Gene0Grey/cuffless-bp-monitor/docs/Cuffless_BP_Monitor_Report.docx

Cuffless Non-Invasive Blood Pressure
Monitoring System

Using ECG (AD8232) and Multi-Site PPG (MAX30102) with Pulse Transit Time

Design, Build & Signal-Processing Report

Platform: ESP32 • Wireless (WiFi) Telemetry

Date: October 2026

# Table of Contents

Right-click here and choose 'Update Field' to build the contents.

# 1. Executive Summary

This report documents the design and construction of a cuffless, non-invasive blood pressure (BP) monitoring system. Unlike conventional cuff-based monitors, the system estimates blood pressure continuously by measuring the Pulse Transit Time (PTT) — the delay between the heart's electrical activity (ECG) and the arrival of the resulting pulse wave at peripheral sites (PPG).

The system uses a single AD8232 ECG module as the timing reference and four MAX30102 photoplethysmography (PPG) sensors placed at multiple body sites (both fingertips and the earlobes). Because all MAX30102 sensors share the same fixed I²C address, a TCA9548A I²C multiplexer addresses them individually. An ESP32 microcontroller performs acquisition, digital filtering, and wireless (WiFi) transmission of the data.

The report covers the measurement principle, system architecture, complete wiring, power-supply design (USB and battery/boost options), the digital signal-processing pipeline developed to obtain clean signals, testing and troubleshooting notes, current limitations, and the roadmap toward the final BP calculation.

# 2. Project Objective

- Build a cuffless, non-invasive system capable of estimating blood pressure continuously.
- Acquire a synchronized ECG signal and multiple PPG signals from different body sites.
- Compute Pulse Transit Time (PTT) between the ECG R-peak and each PPG pulse.
- Map PTT to blood pressure using a per-user calibration against a reference cuff.
- Make the device portable and wireless — battery powered with WiFi telemetry.

# 3. Measurement Principle

Blood pressure is not measured directly. Instead, the system relies on the well-established relationship between arterial pressure and the speed at which the pulse wave travels through the arteries.

## 3.1 Pulse Transit Time (PTT)

Each heartbeat produces a sharp electrical spike — the R-peak — visible on the ECG. This marks the instant the heart contracts (time t = 0). The pressure pulse then travels along the arteries and arrives at a peripheral site (fingertip, earlobe) a short time later, where the PPG sensor detects it as a rise in blood volume.

PTT is the delay between the ECG R-peak and the foot (or peak) of the PPG pulse. A higher blood pressure stiffens the arteries and makes the pulse travel faster, shortening PTT. The relationship is commonly modelled as:

BP ≈ a · (1 / PTT²) + b

where the coefficients a and b are determined for each individual through calibration against a standard cuff reading.

## 3.2 Why multiple PPG sites

Using PPG sensors at both a proximal site (earlobe, short PTT) and distal sites (fingertips, longer PTT) provides multiple transit-time measurements. This improves robustness, allows cross-checking, and helps reject motion artefacts. In this build the ECG provides the shared timing reference, and each PPG stream is aligned to it independently.

# 4. System Architecture

The signal flow of the complete system is summarised below.

- ECG path: AD8232 → analog output → ESP32 ADC (GPIO34). Continuous, high-rate sampling for R-peak detection.
- PPG path: 4 × MAX30102 → TCA9548A I²C multiplexer → ESP32 I²C bus (GPIO21/22). Sensors read one at a time.
- Processing: ESP32 filters both signals digitally and (in the final system) computes PTT and BP.
- Telemetry: ESP32 hosts a WiFi web dashboard for live waveform viewing; USB serial is used during development.
- Power: USB during development; LiPo battery + XL6009 boost converter for portable operation.

The AD8232 is an analog device and therefore bypasses the multiplexer entirely — only the four identical-address PPG sensors require multiplexing.

# 5. Bill of Materials

Component | Part | Qty | Purpose
Microcontroller | ESP32 DevKit (CP2102) | 1 | Acquisition, DSP, WiFi telemetry
I²C multiplexer | TCA9548A | 1 | Address 4 identical PPG sensors
PPG sensor | MAX30102 | 4 | Pulse detection (2 fingers, 2 earlobes)
ECG module | AD8232 + electrodes | 1 | Heart signal / R-peak reference
Battery | LiPo 3.7 V, 1250 mAh | 1 | Portable power source
Boost converter | XL6009 | 1 | Step battery up to a stable 5 V
Capacitors | 2× 470 µF, 2× 0.1 µF | 4 | Decoupling / stabilise boost output
Misc. | Breadboard, jumpers, USB cable | — | Prototyping

# 6. Circuit Connections (USB-Powered Build)

During development the entire circuit is powered from the ESP32's USB port. The regulated 3.3 V pin feeds a common positive rail; all grounds share a common negative rail — this shared ground is essential for I²C and for a clean ECG reading.

## 6.1 Power Rails

From | To
ESP32 3V3 | Breadboard + rail
ESP32 GND | Breadboard − rail

## 6.2 ESP32 → TCA9548A Multiplexer

TCA9548A pin | Connects to
VIN | + rail
GND | − rail
SDA | ESP32 GPIO21
SCL | ESP32 GPIO22
A0, A1, A2 | − rail (I²C address 0x70)
RST | + rail

## 6.3 TCA9548A → 4 × MAX30102 (PPG)

MAX30102 | VIN | GND | SDA → | SCL →
#1 (finger) | + rail | − rail | SD0 | SC0

#2 (finger) | + rail | − rail | SD1 | SC1

#3 (earlobe) | + rail | − rail | SD2 | SC2

#4 (earlobe) | + rail | − rail | SD3 | SC3

The INT / RD / IRD pins on each MAX30102 are left unconnected.

## 6.4 ESP32 → AD8232 (ECG)

AD8232 pin | Connects to
3.3V | + rail
GND | − rail
OUTPUT | ESP32 GPIO34 (ADC1)
LO+ | ESP32 GPIO32
LO− | ESP32 GPIO33
SDN | Leave unconnected

Electrode placement: RA = right collarbone, LA = left collarbone, RL = left lower rib (reference).

# 7. Power Supply Design (Portable Build)

For portable operation the USB cable is replaced by a 3.7 V LiPo battery. Because the battery voltage (3.0–4.2 V) is too low and too variable for the ESP32's onboard regulator, an XL6009 boost converter raises it to a stable 5 V fed into the ESP32 VIN pin.

## 7.1 Main Power Path

From | To
LiPo + | XL6009 IN+
LiPo − | XL6009 IN−
XL6009 OUT+ (set to 5.0 V) | ESP32 VIN
XL6009 OUT− | ESP32 GND

## 7.2 Decoupling Capacitors

The XL6009 ran hot due to input ripple at low battery voltage. Decoupling capacitor pairs (one bulk electrolytic + one ceramic) were added at both the input and output terminals to smooth current surges and reduce heating.

Capacitor | Placed across | Function
470 µF electrolytic | IN+ / IN− | Absorbs input current surges (reduces heat)
0.1 µF ceramic | IN+ / IN− | Removes high-frequency switching noise
470 µF electrolytic | OUT+ / OUT− | Smooths 5 V output (WiFi current spikes)
0.1 µF ceramic | OUT+ / OUT− | Removes high-frequency noise

Key safety notes:

- Set the boost output to exactly 5.0 V with a multimeter before connecting it to the ESP32.
- Observe electrolytic polarity — long leg is +, stripe side is −.
- Never power the ESP32 from USB and the boost converter simultaneously.
- Mount capacitors with short leads, close to the converter terminals.
- Flash firmware over USB first; only then switch to battery power.

# 8. Firmware & Signal Processing

The ESP32 firmware acquires the ECG on a timed loop and reads each PPG sensor through the multiplexer. Raw signals were initially very noisy and prone to saturation, so a multi-stage digital signal-processing (DSP) pipeline was developed.

## 8.1 Acquisition

- Processing loop runs at 200 Hz; data is printed/transmitted at 50 Hz for readable waveforms.
- MAX30102 configured with hardware sample-averaging (×4) and FIFO read to prevent stale-data 'stepping'.
- ECG read from GPIO34 with 16× ADC oversampling to reduce converter noise.
- Multiplexer channel selected before each PPG transaction (ch0=0x01 … ch3=0x08).

## 8.2 Filtering Pipeline

Stage | Technique | Removes / Purpose
Hardware averaging | MAX30102 avg ×4 | Random PPG sensor noise
Oversampling | 16× ADC average (ECG) | ADC jitter
High-pass | Slow EMA baseline subtract | Baseline wander / DC drift
Mains notch | 2nd-order IIR biquad (50/60 Hz) | Power-line hum
Low-pass | 2-pole cascaded EMA | High-frequency fuzz
Median filter | Median-of-3 (PPG) | Motion spikes
Finger gate | DC-level threshold | Prevents empty-channel railing
Gain | Adjustable software gain | Amplifies clean signal

## 8.3 Key Problems Solved

- Saturation at ±8000: empty/no-finger PPG channels were amplified into the clamp. Fixed with a DC-level 'finger-present' gate that outputs a flat zero when no finger is detected.
- Insane values: unconnected channels and failed reads produced huge spikes. Fixed with sensor auto-detection (part-ID 0x15) and failed-read handling.
- Mains hum: replaced a crude moving average with a proper IIR notch tuned to the local mains frequency.
- Scaling conflict: ECG (0–4095) dwarfed PPG on shared plots; the WiFi dashboard shows ECG and PPG in separate, independently auto-scaled panels.

## 8.4 Wireless Telemetry

The ESP32 connects to WiFi (station mode) with a static IP and hosts a lightweight web dashboard. A browser on the same network displays live ECG and PPG waveforms in two separate panels, requiring no additional PC software. USB serial remains available for development and for reading the device IP.

# 9. Testing & Troubleshooting Log

Symptom | Root cause | Resolution
Garbled serial output | Board/crystal or baud mismatch | Correct board selection; 115200 baud
Values 'insane' / spiking | Unconnected channels, failed reads | Sensor auto-detect + read guards
Signal stuck at ±8000 | Gain pushing empty channel to clamp | Finger-presence DC gate
Boost converter overheating | Input ripple at low battery V | Input + output decoupling capacitors
COM port not detected | Descriptor failure (VID_0000) | Data cable + isolate external power

USB connectivity note:

A diagnostic scan confirmed the CP210x driver is installed and the board is registered as COM5. A 'Device Descriptor Request Failed' (VID_0000 & PID_0002) indicated an electrical/physical fault rather than a driver issue — resolved by using a known-good data cable and disconnecting external power (boost/sensors) so the board could enumerate without brownout.

# 10. Limitations

- Calibration required: cuffless PTT-based BP needs per-user calibration against a cuff and drifts over time; best treated as a trend/relative monitor.
- Multiplexed PPG: sensors are read one at a time, so timing must be reconstructed in software rather than sampled simultaneously.
- ESP32 ADC: the internal ADC is noisy; oversampling mitigates but does not eliminate this. An external ADC would improve ECG fidelity.
- Motion sensitivity: PPG and ECG are both susceptible to movement and poor electrode/sensor contact.
- Not a medical device: for research and educational use only; not validated for clinical diagnosis.

# 11. Next Steps & Future Work

1. Implement R-peak detection on the ECG stream (e.g. Pan–Tompkins-style thresholding).
2. Implement PPG pulse-foot detection for each channel.
3. Compute PTT = t(PPG foot) − t(ECG R-peak) per site and per beat.
4. Perform calibration against a reference cuff to derive coefficients a and b.
5. Run on-device BP calculation and transmit only the final BP value.
6. Optionally add OTA updates for fully wireless reflashing, and package into a wearable form factor.

# 12. Conclusion

A complete hardware platform for cuffless blood-pressure estimation has been designed and built around an ESP32, four MAX30102 PPG sensors on a TCA9548A multiplexer, and an AD8232 ECG module. A robust multi-stage DSP pipeline now yields clean, centred ECG and PPG signals, and a WiFi dashboard provides live visualisation. The power-supply and connectivity issues encountered during the build have been diagnosed and resolved. The remaining work is algorithmic: detecting fiducial points, computing PTT, and calibrating the PTT-to-BP mapping to turn the clean signals into blood-pressure readings.

Cuffless BP Monitor — Project Report | Page
