Gene0Grey/cuffless-bp-monitor/hardware/docs/bom.csv

Reference | Value | Footprint | QUANTITY
C1 | 10uF | Capacitor_THT:CP_Radial_D5.0mm_P2.50mm | 1
H1-H4 | MountingHole | MountingHole:MountingHole_3.2mm_M3 | 4
J1 | 5V_IN | ppg:JST_PH_B2B-PH-K_1x02_P2.00mm_Vertical_HandDrill | 1
JP1-JP4 | GND_LINK | ppg:WireLink_P5.08mm | 4
JP5 | RST_3V3 | ppg:WireLink_P5.08mm | 1
U1 | ESP32-DevKitV1 | ppg:ESP32_DevKitV1_30pin | 1
U2 | TCA9548A | ppg:TCA9548A_Module_HW-617 | 1
U3 | PPG1_CH0 | ppg:MAX30102_MH-ET_LIVE | 1
U4 | PPG2_CH1 | ppg:MAX30102_MH-ET_LIVE | 1
U5 | PPG3_CH2 | ppg:MAX30102_MH-ET_LIVE | 1
U6 | PPG4_CH3 | ppg:MAX30102_MH-ET_LIVE | 1
U7 | AD8232 | ppg:AD8232_SparkFun_SEN-12650 | 1
