Gene0Grey/cuffless-bp-monitor/hardware/docs/schematic.pdf

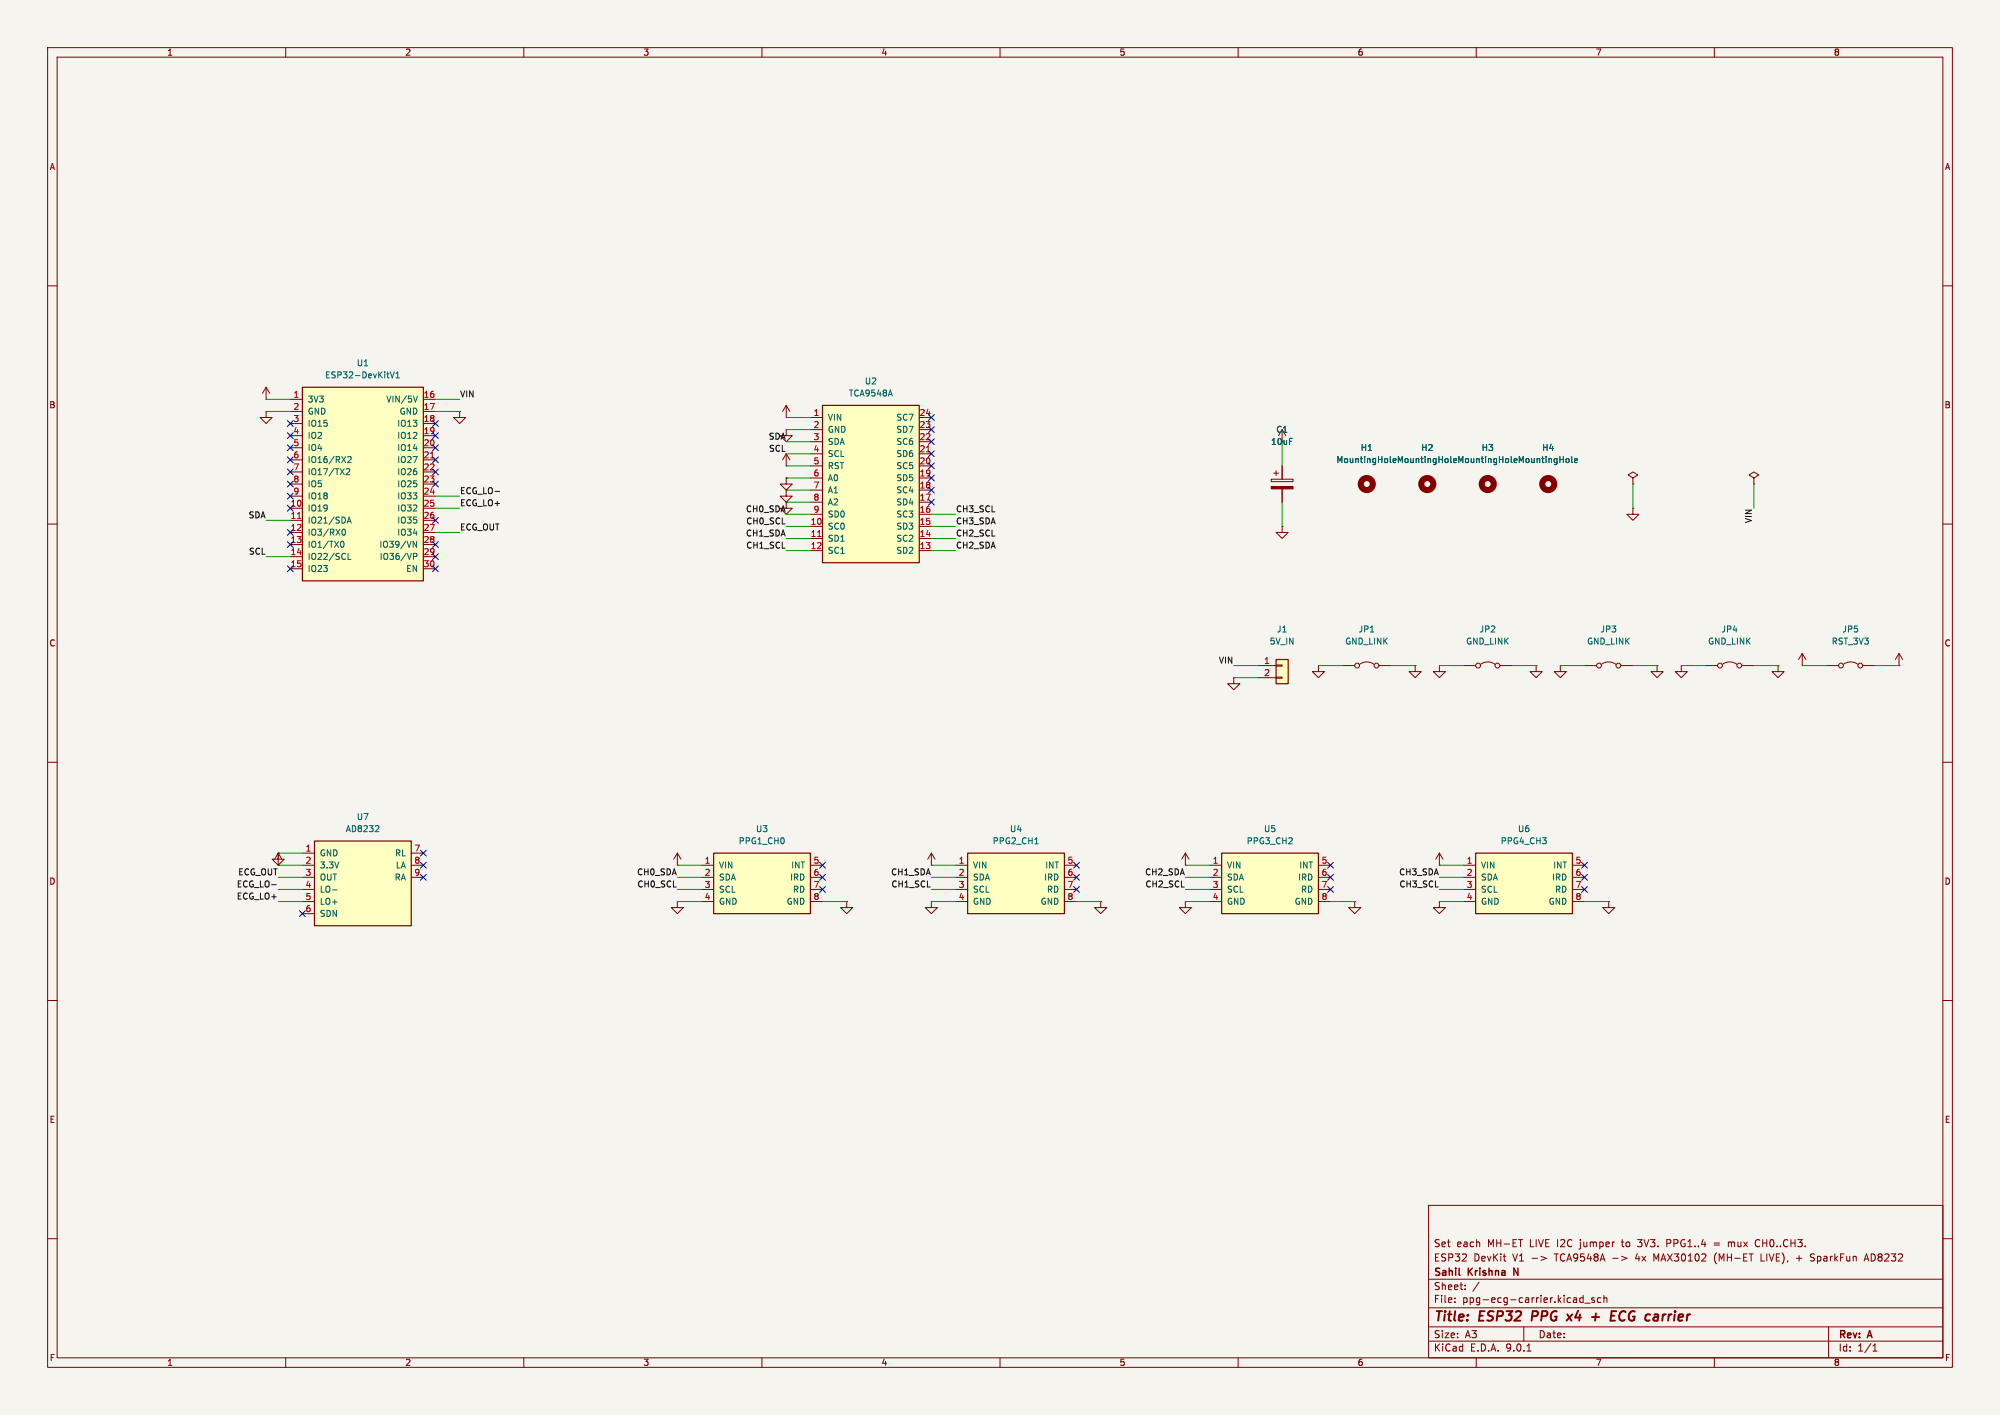
[picture p13: page 1]

VIN 1 SDA 2 SCL 3 GND 4

ESP32 | DevKit V1 -> | MH-ET | LIVE | TCA9548A -> I2C jumper to 3V3. | 4x MAX30102 | PPG1..4 = mux | (MH-ET | CH0..CH3. LIVE), + | SparkFun AD8232 Set each

ppg-ecg-carrier.kicad_sch Sheet: / Sahil Krishna N Id: 1/1 Title: ESP32 PPG x4 + ECG carrier File:
