Gene0Grey/cuffless-bp-monitor/hardware/docs/assembly-top.pdf

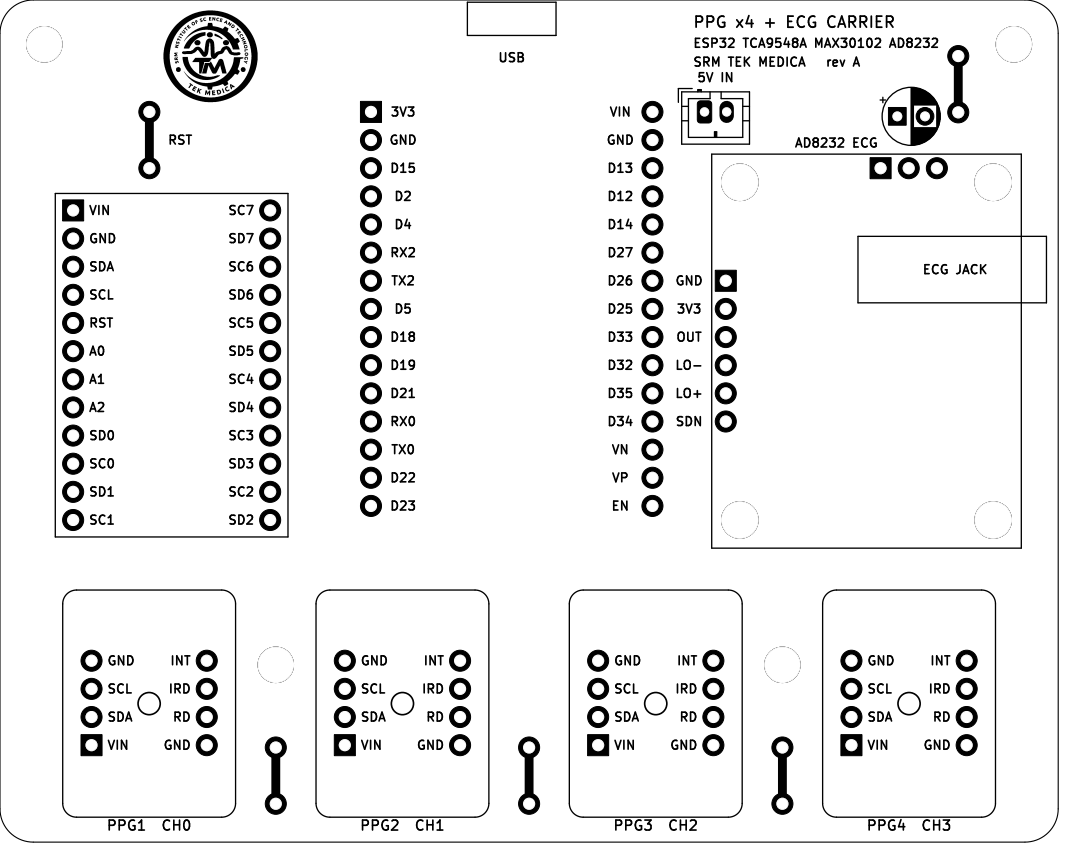
[picture p14: page 1]
