Gene0Grey/cuffless-bp-monitor/hardware/docs/drill-map.pdf

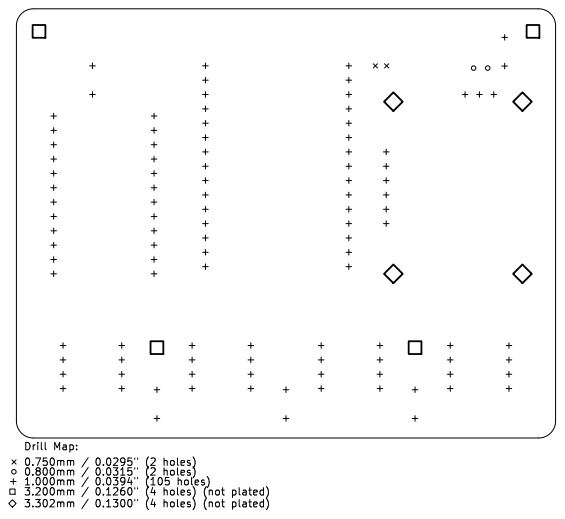
[picture p15: page 1]
