Gene0Grey/cuffless-bp-monitor/hardware/docs/etch-bottom.pdf

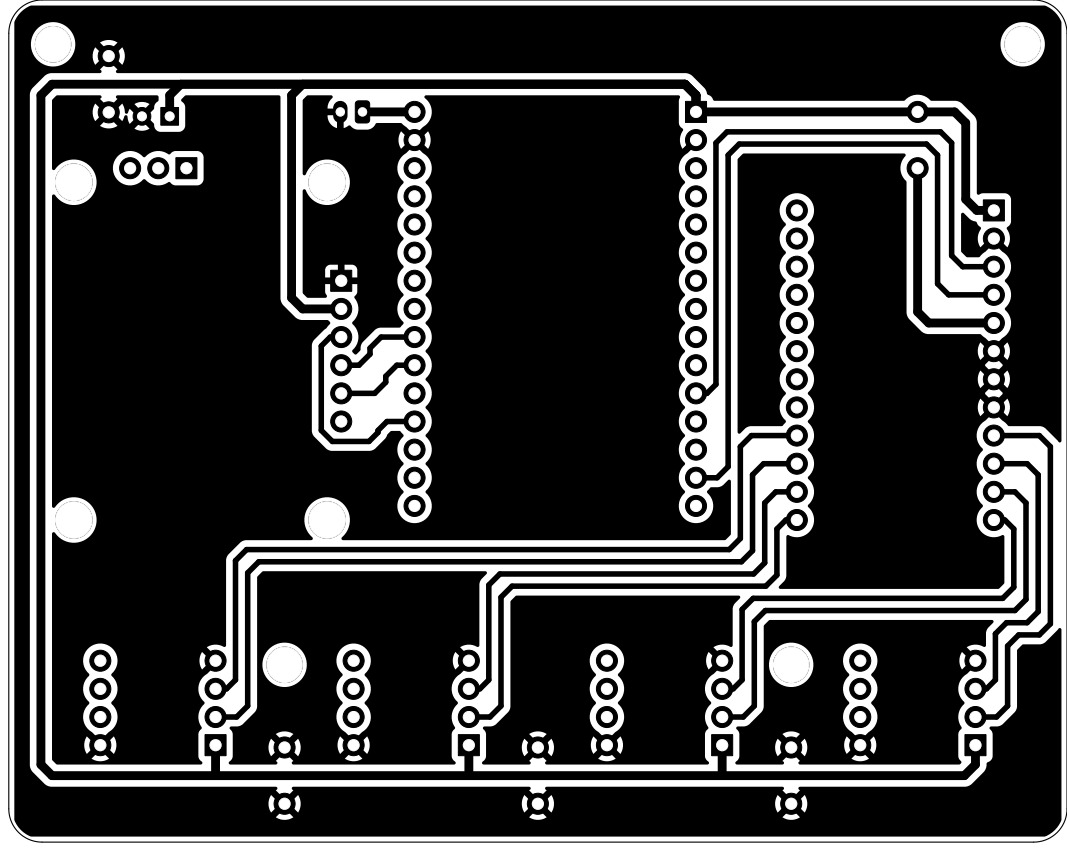
[picture p16: page 1]
