Gene0Grey/cuffless-bp-monitor/hardware/ppg-ecg-carrier.kicad_pcb

## KiCad design hardware/ppg-ecg-carrier.kicad_pcb (2026-10-01)

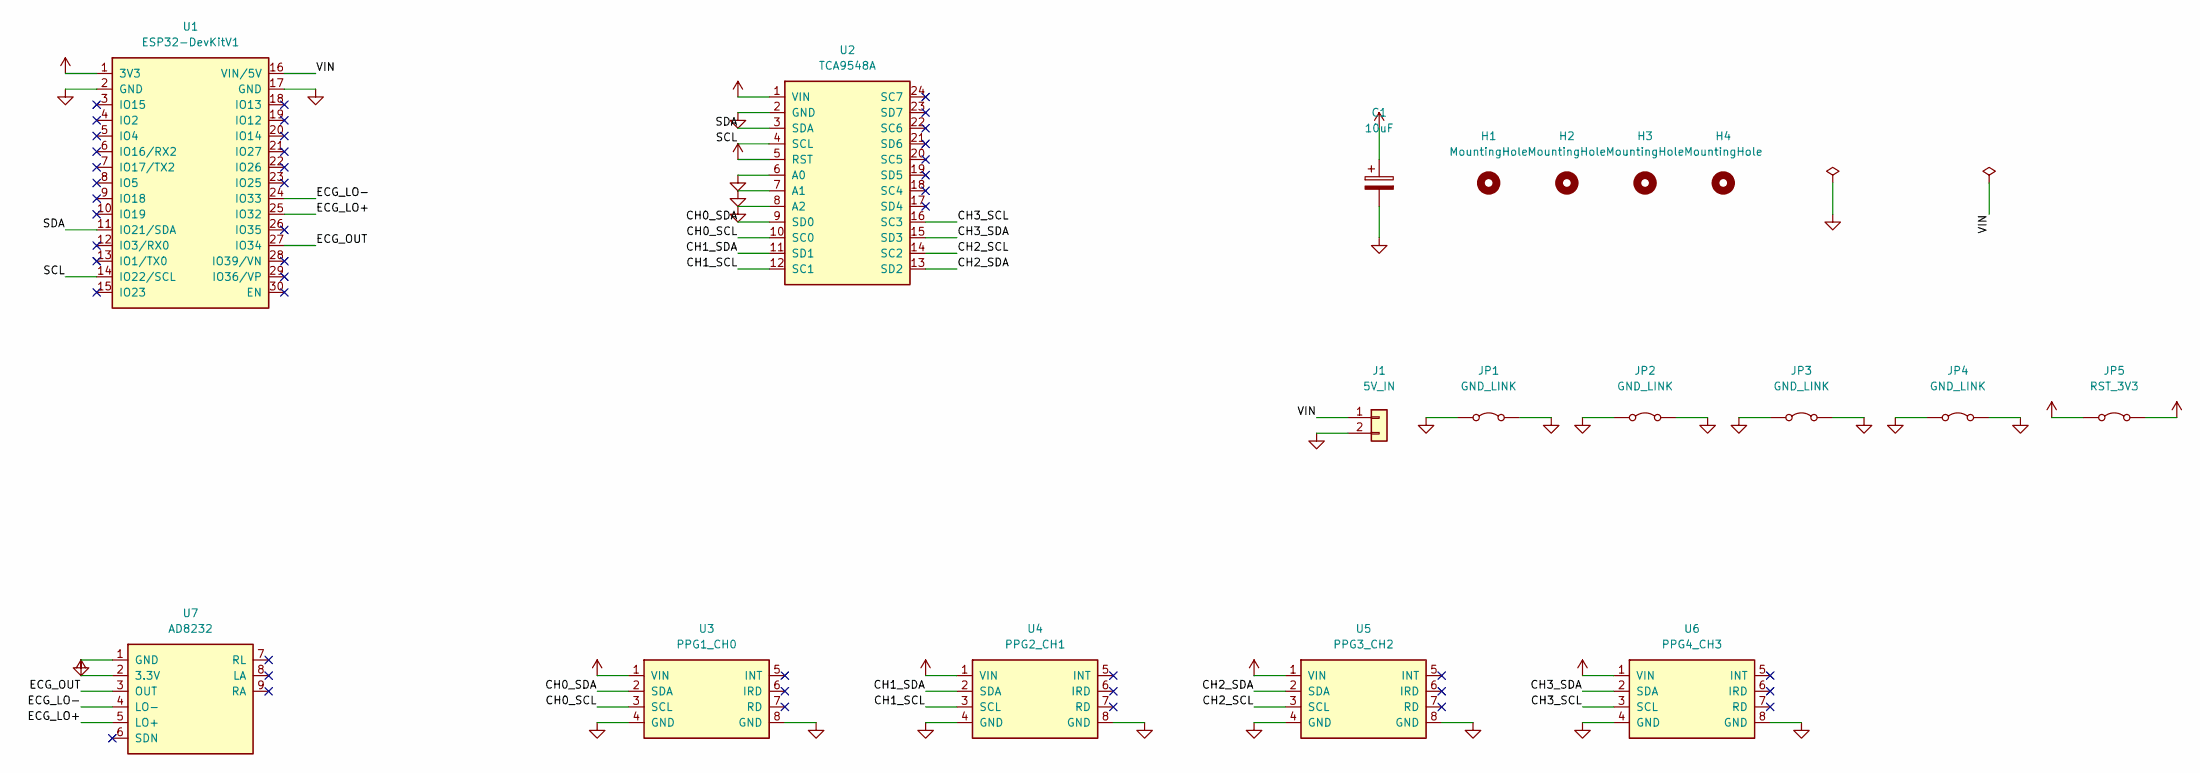
[picture p17: schematic ppg-ecg-carrier.kicad_sch, ESP32 PPG x4 + ECG carrier]

Parts:
C1: 10uF; CP_Radial_D5.0mm_P2.50mm
H1, H2, H3, H4: MountingHole; MountingHole_3.2mm_M3
J1: 5V_IN; JST_PH_B2B-PH-K_1x02_P2.00mm_Vertical_HandDrill
JP1, JP2, JP3, JP4: GND_LINK; WireLink_P5.08mm
JP5: RST_3V3; WireLink_P5.08mm
U1: ESP32-DevKitV1; ESP32_DevKitV1_30pin
U2: TCA9548A; TCA9548A_Module_HW-617
U3: PPG1_CH0; MAX30102_MH-ET_LIVE
U4: PPG2_CH1; MAX30102_MH-ET_LIVE
U5: PPG3_CH2; MAX30102_MH-ET_LIVE
U6: PPG4_CH3; MAX30102_MH-ET_LIVE
U7: AD8232; AD8232_SparkFun_SEN-12650

Connections:
+3V3: C1.1, JP5.1 (A), JP5.2 (B), U1.1 (3V3), U2.1 (VIN), U2.5 (RST), U3.1 (VIN), U4.1 (VIN), U5.1 (VIN), U6.1 (VIN), U7.2 (3.3V)
/CH0_SCL: U2.10 (SC0), U3.3 (SCL)
/CH0_SDA: U2.9 (SD0), U3.2 (SDA)
/CH1_SCL: U2.12 (SC1), U4.3 (SCL)
/CH1_SDA: U2.11 (SD1), U4.2 (SDA)
/CH2_SCL: U2.14 (SC2), U5.3 (SCL)
/CH2_SDA: U2.13 (SD2), U5.2 (SDA)
/CH3_SCL: U2.16 (SC3), U6.3 (SCL)
/CH3_SDA: U2.15 (SD3), U6.2 (SDA)
/ECG_LO+: U1.25 (IO32), U7.5 (LO+)
/ECG_LO-: U1.24 (IO33), U7.4 (LO-)
/ECG_OUT: U1.27 (IO34), U7.3 (OUT)
/SCL: U1.14 (IO22/SCL), U2.4 (SCL)
/SDA: U1.11 (IO21/SDA), U2.3 (SDA)
/VIN: J1.1, U1.16 (VIN/5V)
GND: C1.2, J1.2, JP1.1 (A), JP1.2 (B), JP2.1 (A), JP2.2 (B), JP3.1 (A), JP3.2 (B), JP4.1 (A), JP4.2 (B), U1.2 (GND), U1.17 (GND), U2.2 (GND), U2.6 (A0), U2.7 (A1), U2.8 (A2), U3.4 (GND), U3.8 (GND), U4.4 (GND), U4.8 (GND), U5.4 (GND), U5.8 (GND), U6.4 (GND), U6.8 (GND), U7.1 (GND)

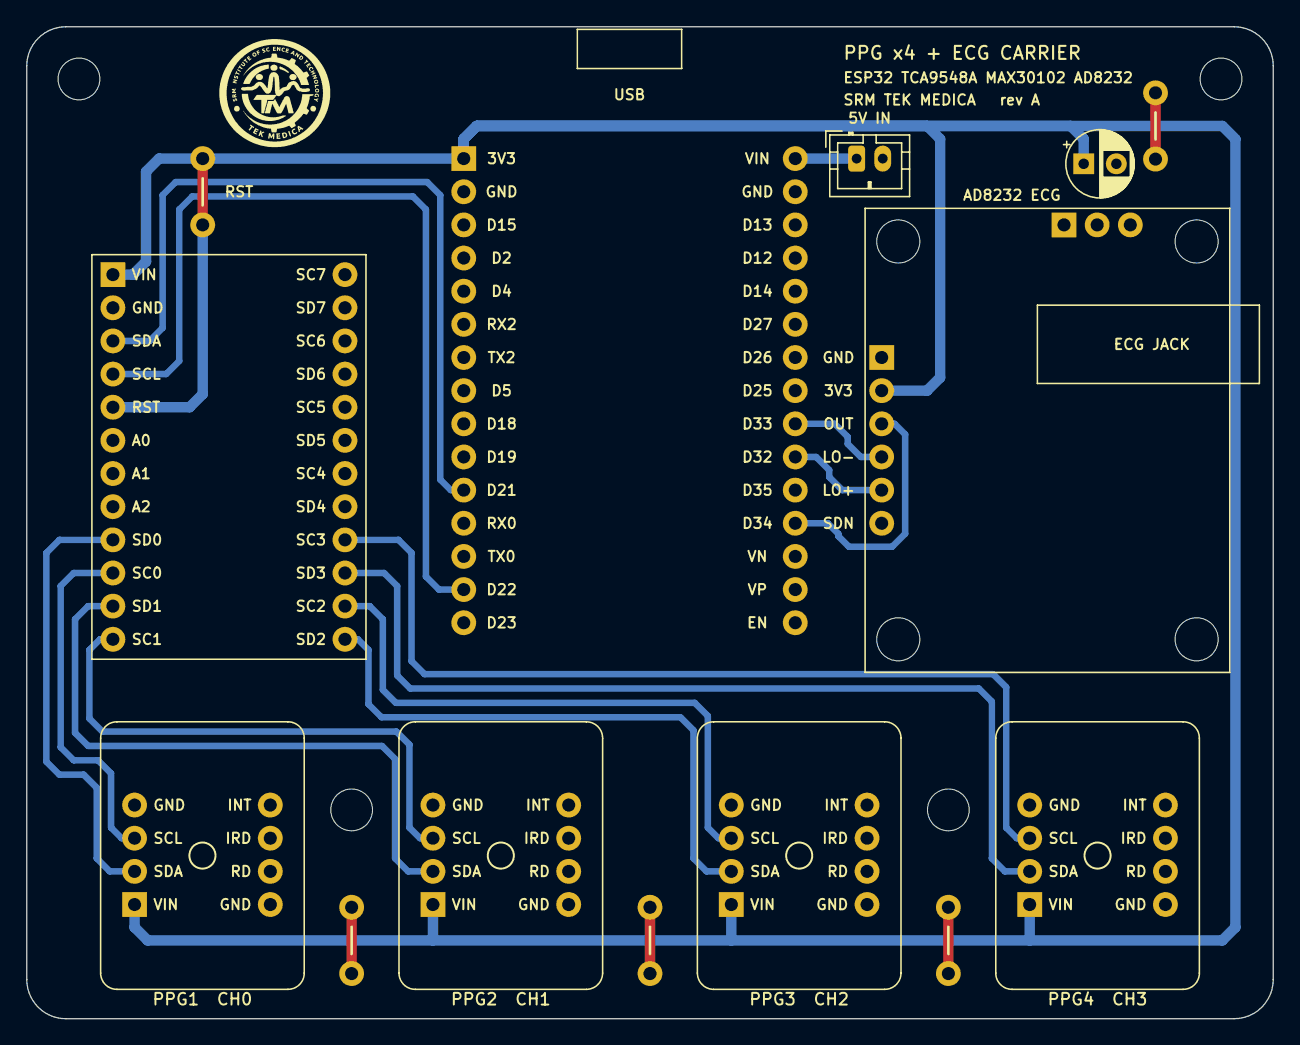
[picture p18: board ppg-ecg-carrier.kicad_pcb from above]

Board: 2 copper layers, 95.5 x 76.0 mm, 18 parts (0 on the bottom side), 16 nets.
