Gene0Grey/cuffless-bp-monitor/(commit log)

2026-10-01 Cuffless BP monitor: carrier PCB, firmware and report
    ESP32 + TCA9548A + 4x MAX30102 (PPG) + AD8232 (ECG) carrier board for
    cuffless blood-pressure estimation by pulse transit time.
    - hardware/: KiCad 9 project, single-sided home-etchable board, Gerbers,
    drill file, renders, schematic and etch/assembly PDFs, BOM
    - firmware/: ESP32 sketch (200 Hz ECG + 4-channel PPG DSP, USB serial)
    - docs/: project report
    [bom.csv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]
2026-10-01 Add renders, schematic image, system and PTT diagrams to README
2026-10-01 Add Wi-Fi live dashboard
    The ESP32 now serves a dashboard to any browser on the network: live ECG
    and four PPG traces, heart rate from the ECG R-peaks, pulse transit time
    per site, per-channel signal status, and session recording to CSV.
    - web.h: joins the Wi-Fi in wifi_secrets.h, falls back to its own hotspot,
    serves the page and streams samples as server-sent events (25 frames/s)
    - dashboard/index.html: the page; dashboard/embed.py packs it into
    dashboard_page.h for the firmware
    - USB serial output is unchanged
